EEJeffMan/LED_Lamp/CONTROLLER_PCB/ESP32 Pinout.xlsx

ESP32 pinout
Num | Desc |  |  |  |  | WROOM-32 Datasheet Recommendation | LORA gateway | WROVER kit | - | Controller PCB
1 | GND |  |  |  |  | GND | GND | GND | - | GND
2 | 3V3 |  |  |  |  | 3V3 | 3V3 | 3V3 | - | 3V3
3 | EN |  |  |  |  | R/C | Auto-reset circuit | RC & auto program circuit | - | RST
4 | SENSOR_VP |  |  |  | A1.0 | SENSOR_VP | NC |  | - | NC
5 | SENSOR_VN |  |  |  | A1.3 | SENSOR_VN | NC |  | - | NC
6 | IO34 |  |  |  | A1.6 | IO | NC | Camera D6 | - | ADC
7 | IO35 |  |  |  | A1.7 | IO | NC | Camera D7 | - | ADC
8 | IO32/32kHz | 32kHz |  |  | A1.4 | IO | RFM_DIO2 | 32kHz | - | 32kHz
9 | IO33/32kHz | 32kHz |  |  | A1.5 | IO | RFM_DIO1 | 32kHz | - | 32kHz
10 | IO25 |  |  |  | A2.8 | IO | IO | LCD SDO (MISO1) | - | BOOST_EN
11 | IO26 |  |  |  | A2.9 | IO | RFM_INT | Camera SIO_D | - | BOOST_BYPASS
12 | IO27 |  |  |  | A2.7 | IO | IO | Camera SIO_C | - | DATA_OUT
13 | IO14 | MTMS | SD_CLK | SPI_SCK | A2.6 | 100 ohm to JTAG | SPI_SCK | JTAG MTMS w/pullup & SD_CLK | - | SPI SCK
14 | IO12 | MTDI | SD_DATA2 | SPI_MISO | A2.5 | 100 ohm to JTAG | SPI_MISO | JTAG MTDI w/pullup & SD_DATA2 | - | SPI MISO | Strapping pin
15 | GND | - | - | - | - | GND | GND | GND | - | GND
16 | IO13 | MTCK | SD_DATA3 | SPI_MOSI | A2.4 | 100 ohm to JTAG | SPI_MOSI | Switch to nRTS & JTAG MTCK w/pulldown & SD_DATA3 | - | SPI MOSI & nRTS option
17 | IO9 | SHD | SD_DATA2 | SPIHD | U1RXD | NC | NC | JTAG SD2 | - | NC | Internal SPI flash
18 | IO10 | SWP | SD_DATA3 | SPIWP | U1TXD | NC | NC | JTAG SD3 | - | NC | Internal SPI flash
19 | IO11 | SCS | SD_CMD | SPICS0 | U1RTS | NC | NC | JTAG CMD | - | NC | Internal SPI flash
20 | IO6 | SCK | SD_CLK | SPICLK | U1CTS | NC | NC | JTAG CLK | - | NC | Internal SPI flash
21 | IO7 | SDO | SD_DATA0 | SPIQ | U2RTS | NC | NC | JTAG SD0 | - | NC | Internal SPI flash
22 | IO8 | SDI | SD_DATA1 | SPID | U2CTS | NC | NC | JTAG SD1 | - | NC | Internal SPI flash
23 | IO15 | MTDO | SD_CMD |  | A2.3 | 100 ohm to JTAG | NC | Switch to nCTS & JTAG MTDO w/pullup & SD_CMD | - | nCTS option | Strapping pin
24 | IO2 |  | SX_DATA0 |  | A2.2 | IO | NC | Pulldown & auto program circuit | - | TP & Pulldown & auto program circuit | Strapping pin
25 | IO0 | CLK_OUT1 |  |  | A2.1 | Jumper to GND for boot option | Button & auto-reset circuit | Pullup & auto program circuit | - | TP & Pullup & auto program circuit | Strapping pin
26 | IO4 |  | SD_DATA1 |  | A2.0 | IO | IO | Camera D0 & SD_DATA1 & RGB | - | LED_GREEN
27 | IO16 |  |  |  | U2RXD | IO | RFM_CS | IO | - | Extra UART header
28 | IO17 |  |  |  | U2TXD | IO | IO & LED | IO | - | Extra UART header
29 | IO5 |  |  |  |  | IO | IO | Camera D1 & LCD LED control | - | TP | Strapping pin
30 | IO18 |  |  |  |  | IO | IO | Camera D2 & LCD RST | - | LED_YELLOW
31 | IO19 |  |  |  | U0CTS | IO | IO | Camera D3 & LCD CLK | - | LED_RED
32 | NC | - | - | - | - | NC | NC | Tied to pin 37 | - | TP
33 | IO21 |  |  | I2C_SDA |  | IO | I2C_SDA | Camera XCLK & LCD D/C & SD DET (CD) | - | I2C SDA
34 | RXDO |  |  |  | U0RXD | UART download | RXI CH340C | FT232 via jumper | - | 0 ohm to UART TX | Place 0 ohm in series
35 | TXDO |  |  |  | U0TXD | UART download | TXO CH340C | FT232 via jumper | - | 0 ohm to UART RX | Place 0 ohm in series
36 | IO22 |  |  | I2C_SCL | U0RTS | IO | I2C_SCL | Camera PCLK & LCD CS | - | I2C SCL
37 | IO23 |  |  |  |  | IO | IO | Camera HREF & LCD MOSI (SDA) | - | TP
38 | GND | - | - | - | - | GND | GND | GND | - | GND
