EEJeffMan/LED_Lamp/POWER_PCB/Power PCB FB Node.png

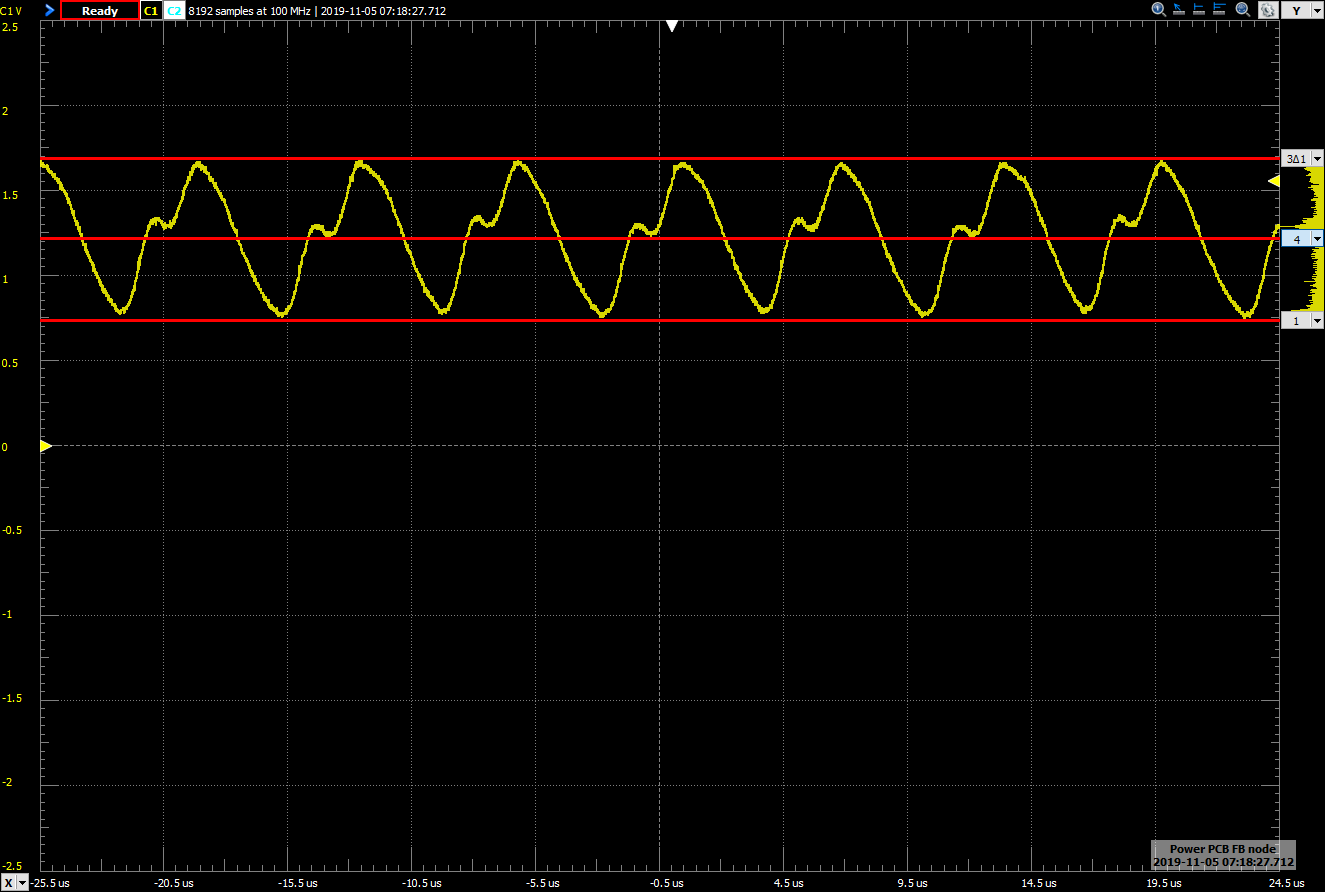
POWER_PCB/Power PCB FB Node.png
