EEJeffMan/LED_Lamp/POWER_PCB/Power PCB SW Node.png

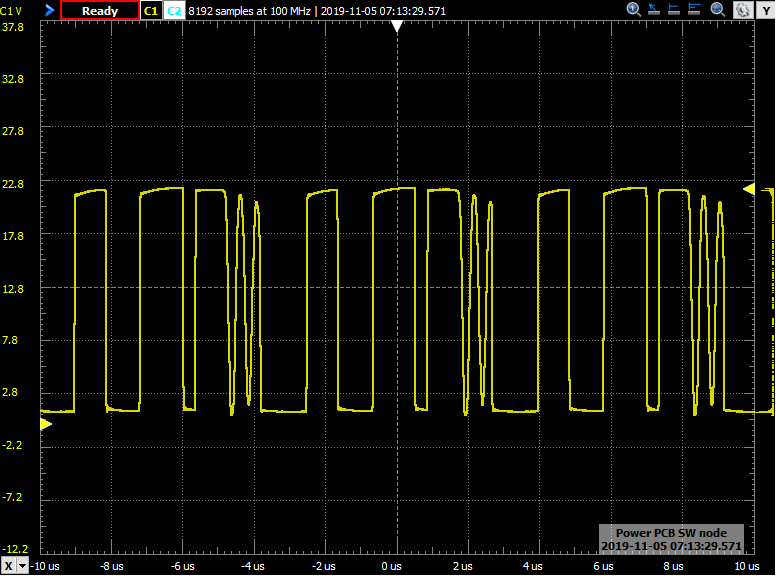
POWER_PCB/Power PCB SW Node.png
