EEJeffMan/LED_Lamp/POWER_PCB/Power PCB VOUT Node.png

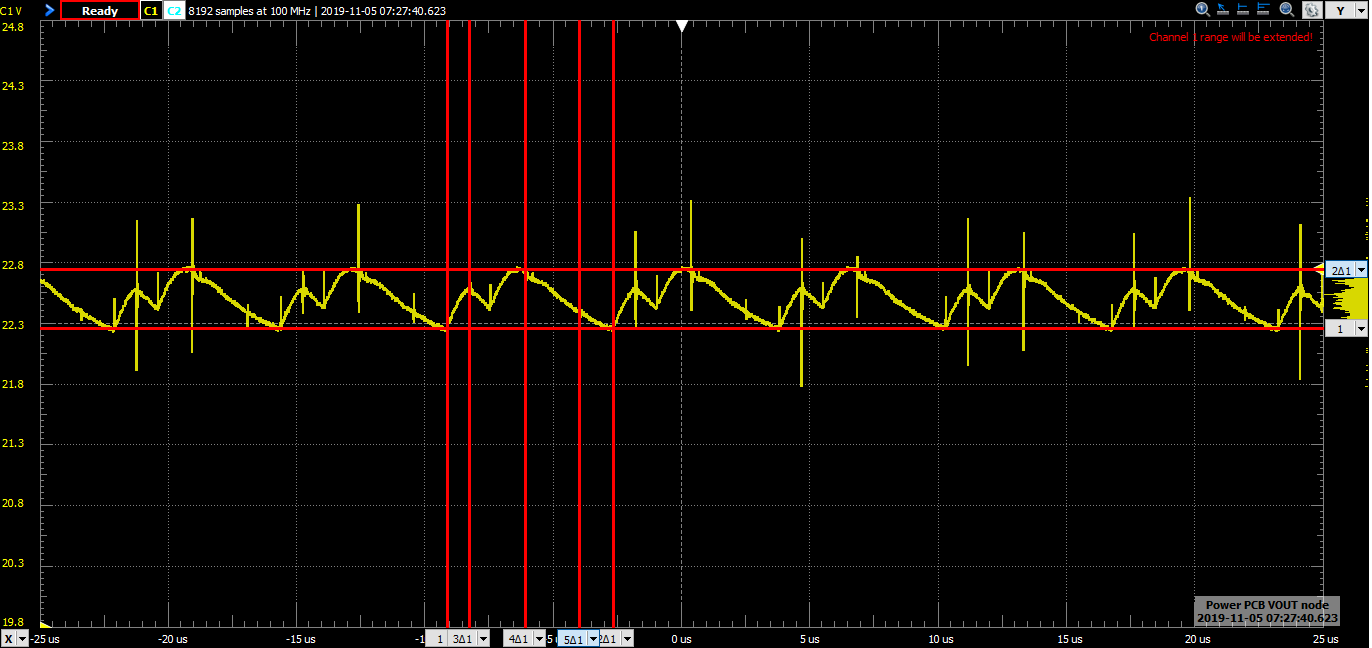
POWER_PCB/Power PCB VOUT Node.png
