EEJeffMan/LED_Lamp/LED_PCB/LED_PCB.pdf

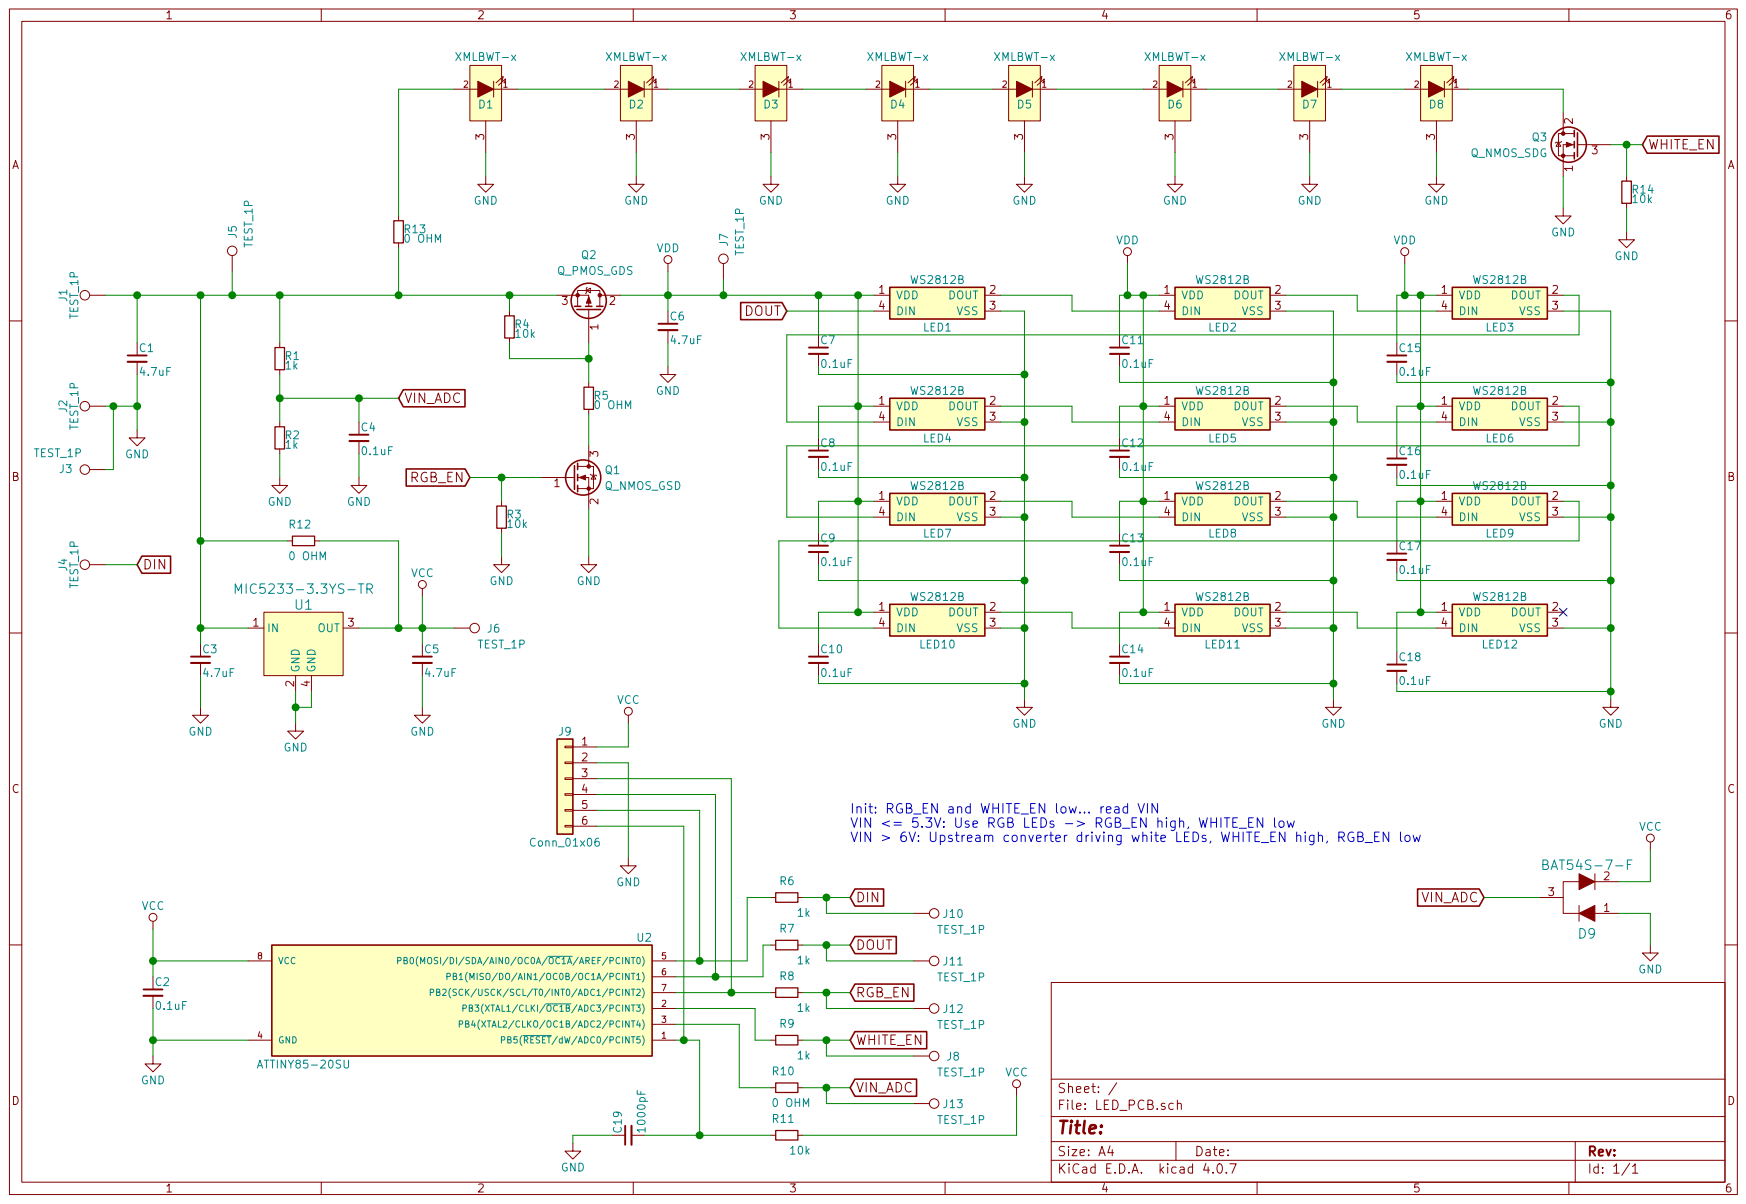
[picture p11: page 1]
