EEJeffMan/LED_Lamp/CONTROLLER_PCB/CONTROLLER_PCB.kicad_pcb

## KiCad design CONTROLLER_PCB/CONTROLLER_PCB.kicad_pcb (2019-03-01)

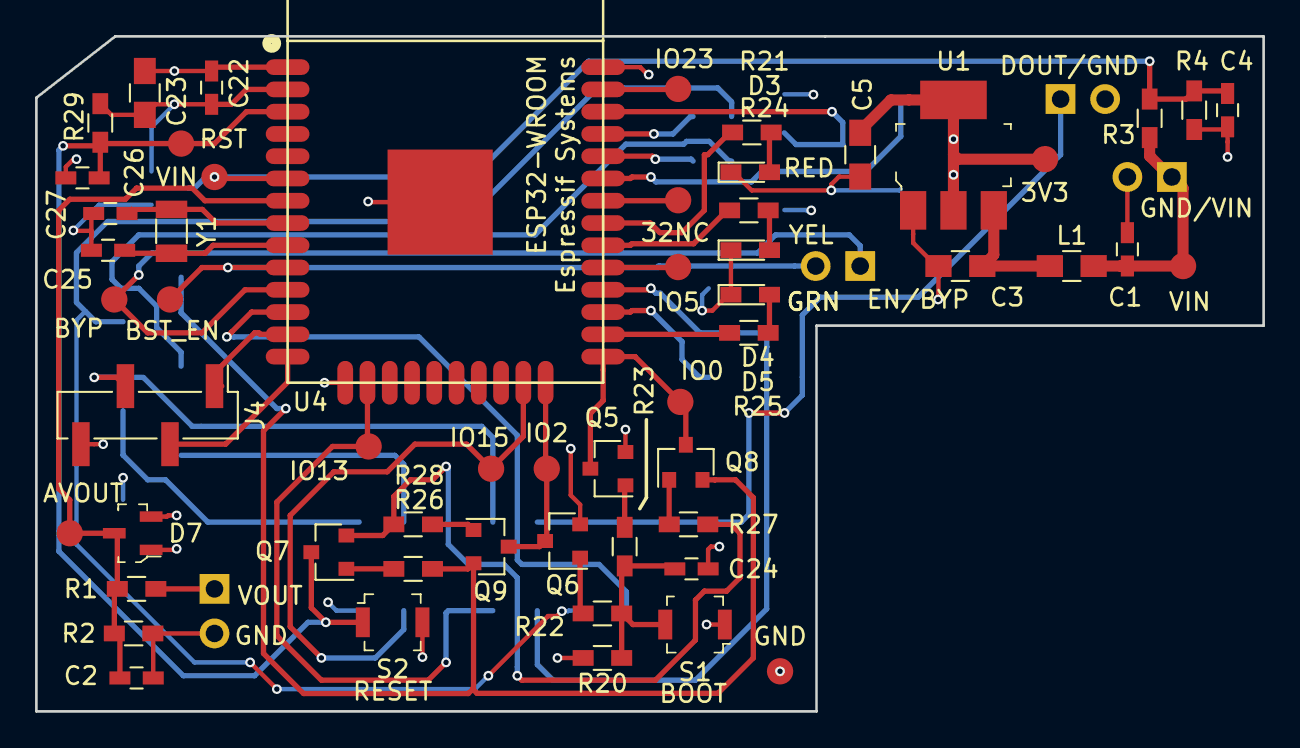
[picture p12: board CONTROLLER_PCB.kicad_pcb from above]

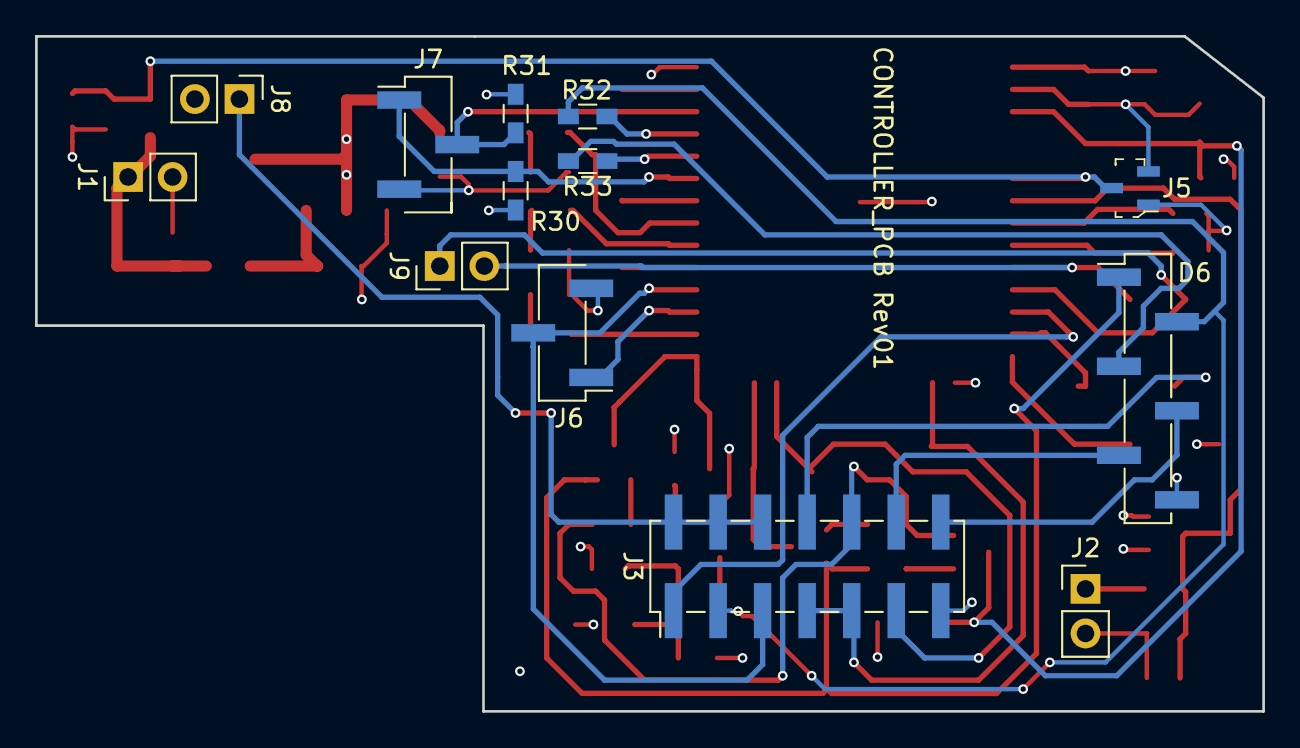
[picture p13: board CONTROLLER_PCB.kicad_pcb from below]

Board: 4 copper layers, 70.0 x 38.5 mm, 69 parts (13 on the bottom side), 48 nets.

Parts:
3V3, 32NC: TEST; Measurement_Point_Round-SMD-Pad_Small
AVOUT: TEST; Measurement_Point_Round-SMD-Pad_Small
BST_EN: TEST; Measurement_Point_Round-SMD-Pad_Small
BYP: TEST; Measurement_Point_Round-SMD-Pad_Small
C1, C2, C4, C22, C24, C27: 0.1uF; C_0603_HandSoldering
C3, C5, C23: 10uF; C_0805_HandSoldering
C25, C26: C_Small; C_0603_HandSoldering
D3: Red; LED_0603_HandSoldering
D4: Yellow; LED_0603_HandSoldering
D5: Green; LED_0603_HandSoldering
D6, D7: BAT54S-7-F; SOT-23-3
GND: TEST; Measurement_Point_Round-SMD-Pad_Small
IO0, IO2, IO5, IO13, IO15, IO23: TEST; Measurement_Point_Round-SMD-Pad_Small
J1, J2, J8, J9: Conn_01x02; Pin_Header_Straight_1x02_Pitch2.54mm
J3: Conn_02x07_Odd_Even; Pin_Header_Straight_2x07_Pitch2.54mm_SMD
J4: Conn_01x04; Pin_Header_Straight_1x04_Pitch2.54mm_SMD_Pin1Left
J5: Conn_01x06; Pin_Header_Straight_1x06_Pitch2.54mm_SMD_Pin1Left
J6, J7: Conn_01x03; Pin_Header_Straight_1x03_Pitch2.54mm_SMD_Pin1Left
L1: Ferrite_Bead; C_0805_HandSoldering
Q5, Q6: Q_NMOS_GSD; SOT-23
Q7, Q8, Q9: Q_NPN_BEC; SOT-23
R1, R3, R21, R22, R23, R24, R25, R26, R27, R28, R29: 10k; R_0603_HandSoldering
R2: 1k; R_0603_HandSoldering
R4: 2.49k; R_0603_HandSoldering
R20: 100k; R_0603_HandSoldering
R30, R31: 2.2k; R_0603_HandSoldering
R32, R33: 0 OHM; R_0603_HandSoldering
RST: TEST; Measurement_Point_Round-SMD-Pad_Small
S1, S2: B3U-1000P; Switch_Tactile_SMD_B3U-1000P
U1: AZ1117CH-3_3TRG1; SOT-223
U4: ESP32-WROOM
VIN: TEST; Measurement_Point_Round-SMD-Pad_Small
VIN#2: TEST; Measurement_Point_Round-SMD-Pad_Small
Y1: 32.768 kHz; Crystal_SMD_3215-2pin_3.2x1.5mm

Connections:
3V3_UART: J3.14, J5.4
32KHZ_IN: C26.1, U4.8, Y1.2
32KHZ_OUT: C25.1, U4.9, Y1.1
+3V3: 3V3.1, C5.1, C22.1, C23.1, D6.2, D7.2, J3.13, R29.1, R30.1, R31.1, S1.1, U1.2, U1.4, U4.2
ADC_VIN: C4.1, D6.3, R3.2, R4.1, RST.1, U4.6
ADC_VOUT: AVOUT.1, C2.1, D7.3, R1.2, R2.1, U4.7
BOOST_BYPASS: BYP.1, J9.1, U4.11
BOOST_EN: BST_EN.1, J9.2, U4.10
DOUT: J3.2, J3.4, J3.6, J8.1
DO_0: J3.1, U4.12
GND: C1.2, C2.2, C3.2, C4.2, C5.2, C22.2, C23.2, C24.2, C25.2, C26.2, C27.2, D3.1, D4.1, D5.1, D6.1, D7.1, GND.1, J1.2, J2.2, J4.4, J5.6, J6.3, J7.3, J8.2, Q5.2, Q6.2, R2.2, R4.2, R20.2, S2.2, U1.1, U4.1, U4.15, U4.38, U4.39
I2C_SCL: J7.2, R31.2, U4.36
I2C_SDA: J7.1, R30.2, U4.33
IO0: IO0.1, Q5.3, Q8.3, U4.25
IO2: IO2.1, Q6.3, Q9.3, U4.24
IO13: IO13.1, J3.7, J3.9, U4.16
IO15: IO15.1, J3.11, U4.23
LED_GREEN: R25.1, U4.26
LED_RED: R21.1, U4.31
LED_YELLOW: R24.1, U4.30
unnamed: C3.1, L1.1, U1.3
unnamed: C24.1, R20.1, R22.1, R23.1, S1.2
unnamed: D3.2, R21.2
unnamed: D4.2, R24.2
unnamed: D5.2, R25.2
unnamed: J2.1, R1.1
unnamed: Q5.1, R23.2
unnamed: Q6.1, R22.2
unnamed: Q7.1, R26.2
unnamed: Q8.1, R27.2
unnamed: Q9.1, R28.2
unnamed: R32.1, U4.35
unnamed: R33.1, U4.34
unnamed: IO23.1, U4.37
unnamed: 32NC.1, U4.32
unnamed: IO5.1, U4.29
RXDI: J5.3, R33.2
SPI_MISO: J4.2, U4.14
SPI_MOSI: J3.8, J4.3
SPI_SCK: J4.1, U4.13
TXDO: J3.3, J5.2, R32.2
U2RXD: J6.1, U4.27
U2TXD: J3.5, J6.2, U4.28
Vin: C1.1, J1.1, L1.2, R3.1, VIN.1
~CTS: J3.12, J5.5
~DTR: J5.1, Q8.2, Q9.2, R26.1
~RST: C27.1, Q7.3, R29.2, S2.1, U4.3, VIN#2.1
~RTS: J3.10, Q7.2, R27.1, R28.1
