EEJeffMan/LED_Lamp/POWER_PCB/POWER_PCB.kicad_pcb

## KiCad design POWER_PCB/POWER_PCB.kicad_pcb (2019-03-01)

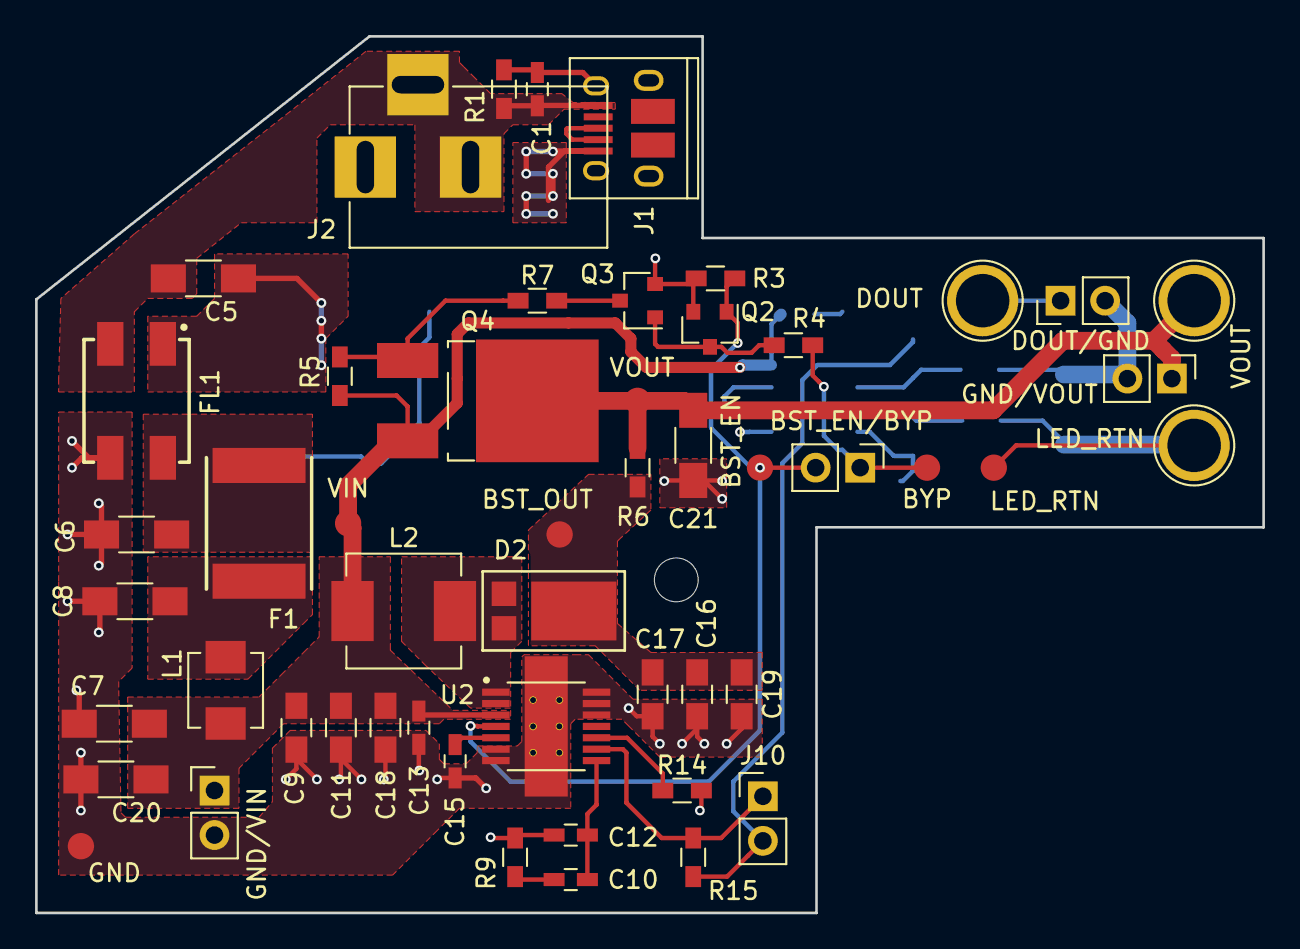
[picture p14: board POWER_PCB.kicad_pcb from above]

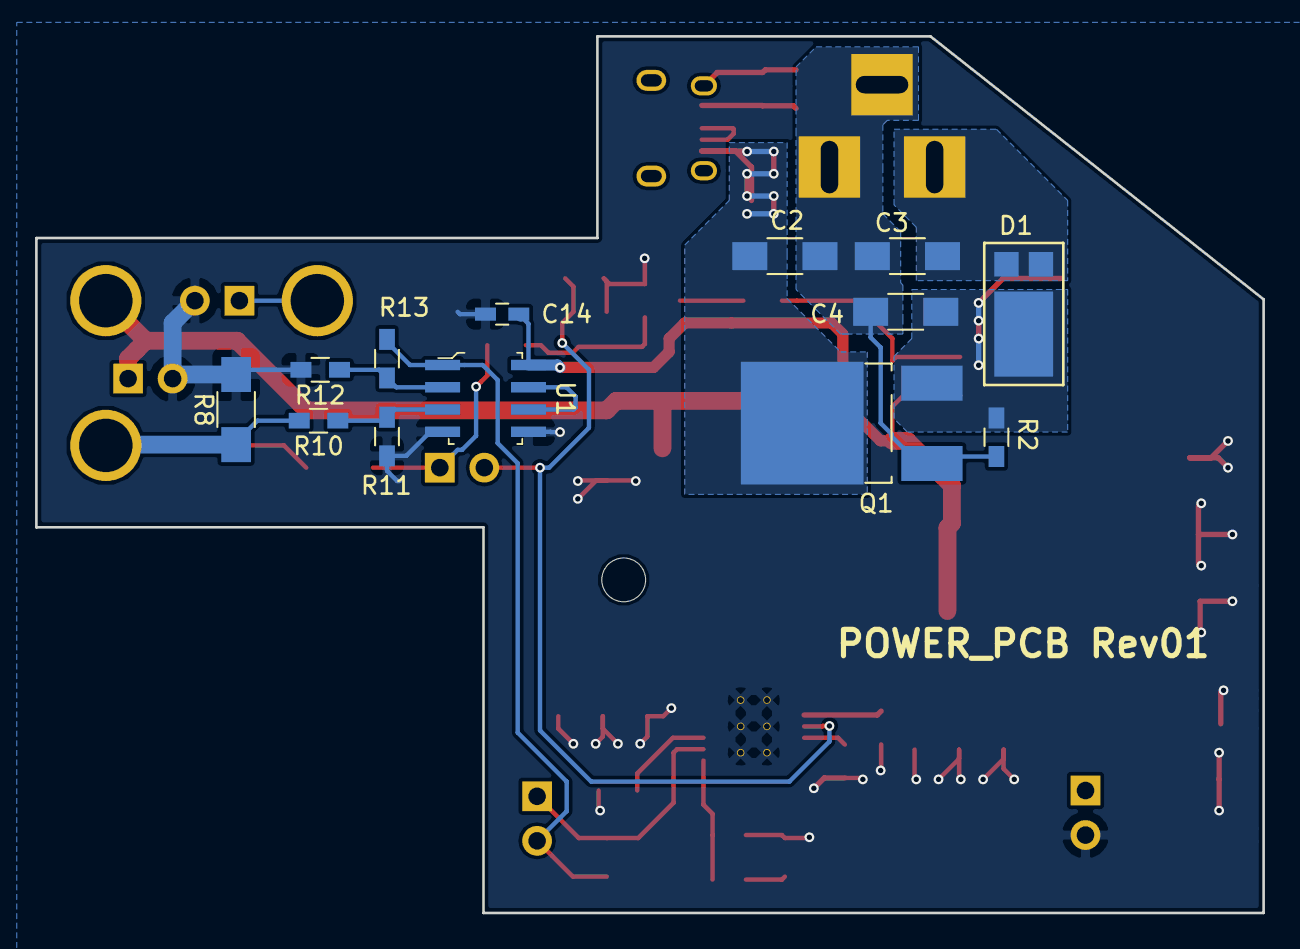
[picture p15: board POWER_PCB.kicad_pcb from below]

Board: 2 copper layers, 70.0 x 50.0 mm, 65 parts (13 on the bottom side), 29 nets.

Parts:
BST_EN: TEST; Measurement_Point_Round-SMD-Pad_Small
BST_EN/BYP: Conn_01x02; Pin_Header_Straight_1x02_Pitch2.54mm
BST_OUT: TEST; Measurement_Point_Round-SMD-Pad_Small
BYP: TEST; Measurement_Point_Round-SMD-Pad_Small
C1, C12: 100p; C_0603_HandSoldering
C2, C3, C4, C5, C6, C7, C8, C20, C21: 22uF; C_1206_HandSoldering
C9, C11, C16, C17, C18, C19: 10uF; C_0805_HandSoldering
C10, C13, C14: 0.1uF; C_0603_HandSoldering
C15: 0.01uF; C_0603_HandSoldering
D1, D2: D_Schottky_AKA; Diodes_Incorporated_POWERDI_5
DOUT: Conn_01x01; 1pin
DOUT/GND: Conn_01x02; Pin_Header_Straight_1x02_Pitch2.54mm
F1: Polyfuse; 2920L
FL1: EMI_Filter_LL_14_23; FIL_ACM70V-701-2PL-TL00
GND: TEST; Measurement_Point_Round-SMD-Pad_Small
GND/VIN: Conn_01x02; Pin_Header_Straight_1x02_Pitch2.54mm
GND/VOUT: Conn_01x02; Pin_Header_Straight_1x02_Pitch2.54mm
J1: 10103594-0001LF; USB_Micro-B_10103594-0001LF
J2: Barrel_Jack; BARREL_JACK
J10: Conn_01x02; Pin_Header_Straight_1x02_Pitch2.54mm
L1: 1uH; L_Vishay_IHLP-1616
L2: 10uH; L_Vishay_IHLP-2525
LED_RTN: Conn_01x01; 1pin
LED_RTN#2: TEST; Measurement_Point_Round-SMD-Pad_Small
Q1, Q4: Q_PMOS_GDS; TO-252-2_Rectifier
Q2, Q3: Q_NMOS_GSD; SOT-23
R1: 1M; R_0603_HandSoldering
R2: 20k; R_0603_HandSoldering
R3, R5, R11, R13: 10k; R_0603_HandSoldering
R4, R10, R12: 1k; R_0603_HandSoldering
R6, R7: 0 OHM; R_0603_HandSoldering
R8: 0.25 OHM; R_1206_HandSoldering
R9: 2.2k; R_0603_HandSoldering
R14: 30k; R_0603_HandSoldering
R15: 100 OHM; R_0603_HandSoldering
U1: TS462CDT; SOIC-8_W3.9mm
U2: TPS55340PWP; SOP65P640X120-15N_HAND_SOLDERING
VIN: TEST; Measurement_Point_Round-SMD-Pad_Small
VOUT: Conn_01x01; 1pin
VOUT#2: TEST; Measurement_Point_Round-SMD-Pad_Small

Connections:
/Input_Output/Vout: C21.1, GND/VOUT.1, Q4.2, R6.1, VOUT.1, VOUT#2.1
BOOST_BYPASS: BST_EN/BYP.1, BYP.1, R4.2
BOOST_EN: BST_EN.1, BST_EN/BYP.2, Q2.1, R3.1, U2.4
BOOST_OUT: BST_OUT.1, C16.1, C17.1, C19.1, D2.2, R6.2
DOUT: DOUT.1, DOUT/GND.1
GND: C6.2, C7.2, C8.2, C9.2, C11.2, C12.2, C13.2, C14.2, C15.2, C16.2, C17.2, C18.2, C19.2, C20.2, C21.2, DOUT/GND.2, FL1.3, GND.1, GND/VIN.2, GND/VOUT.2, Q2.2, Q3.2, R3.2, R8.2, R9.2, R11.2, R12.2, R14.2, U1.4, U1.5, U2.6, U2.7, U2.12, U2.13, U2.14, U2.15, U2.P$1, U2.P$2, U2.P$3, U2.P$4, U2.P$5, U2.P$6
LED_RTN: LED_RTN.1, LED_RTN#2.1, R8.1, R10.2
unnamed: C1.1, J1.6, R1.1
unnamed: C1.2, C2.2, C3.2, C4.2, C5.2, FL1.2, J1.5, J2.2, J2.3, Q1.1, R1.2, R2.2
unnamed: C2.1, J1.1, Q1.2
unnamed: C3.1, D1.1, D1.3, J2.1
unnamed: C4.1, C5.1, D1.2, FL1.1, Q1.3, R2.1
unnamed: C6.1, F1.2, FL1.4
unnamed: C8.1, F1.1, L1.1
unnamed: C10.1, C12.1, U2.8
unnamed: C10.2, R9.1
unnamed: C15.1, U2.5
unnamed: D2.1, D2.3, L2.2, U2.1, U2.2
unnamed: J1.2, J1.3
unnamed: J10.1, R15.1, U2.9
unnamed: J10.2, R13.1, R15.2, U1.1
unnamed: Q2.3, Q3.1, R4.1
unnamed: Q3.3, R7.2
unnamed: Q4.1, R5.2, R7.1
unnamed: R10.1, R11.1, U1.3
unnamed: R12.1, R13.2, U1.2
unnamed: R14.1, U2.10
unnamed: U1.6, U1.7
Vin: C7.1, C9.1, C11.1, C13.1, C14.1, C18.1, C20.1, GND/VIN.1, L1.2, L2.1, Q4.3, R5.1, U1.8, U2.3, VIN.1
