EEJeffMan/LED_Lamp/LED_PCB/LED_PCB.kicad_pcb

## KiCad design LED_PCB/LED_PCB.kicad_pcb (2019-02-09)

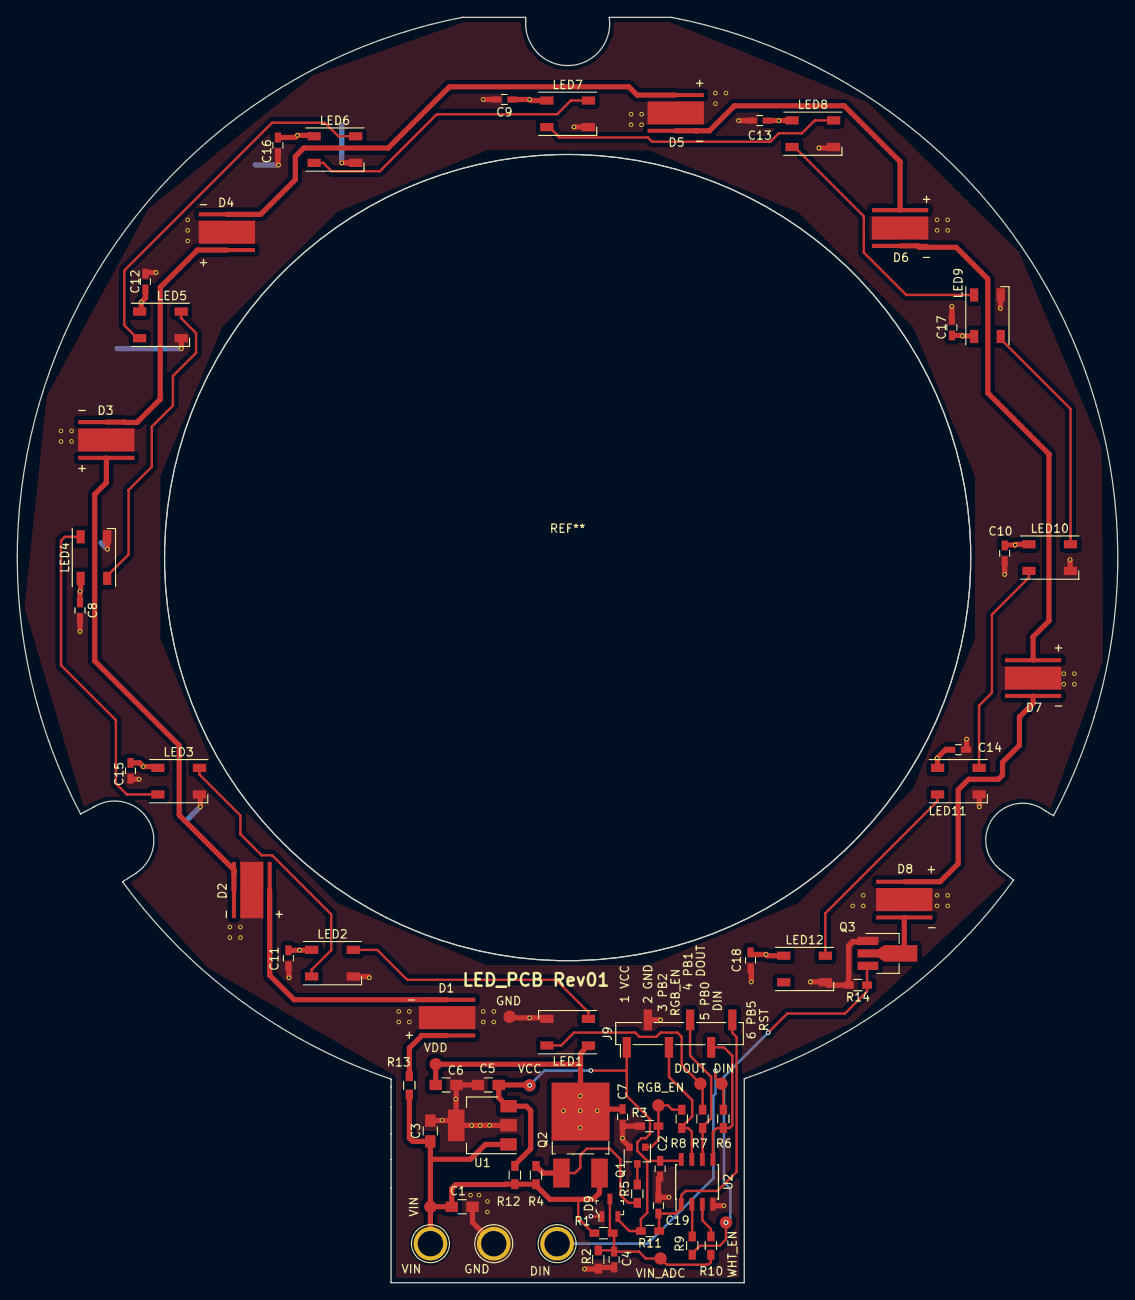
[picture p16: board LED_PCB.kicad_pcb from above]

Board: 2 copper layers, 132.4 x 152.3 mm, 72 parts (0 on the bottom side), 37 nets.

Parts:
C1, C3, C5, C6: 4.7uF; C_0805_HandSoldering
C2, C4, C7, C8, C9, C10, C11, C12, C13, C14, C15, C16, C17, C18: 0.1uF; C_0603_HandSoldering
C19: 1000pF; C_0603_HandSoldering
D1, D2, D3, D4, D5, D6, D7, D8: XMLBWT-x; CREE-XM-L_HAND_SOLDERED
D9: BAT54S-7-F; SOT-23-3
DIN: TEST_1P; 1pin
DIN#2: TEST_1P; Measurement_Point_Round-SMD-Pad_Small
DOUT: TEST_1P; Measurement_Point_Round-SMD-Pad_Small
GND: TEST_1P; 1pin
GND#2: TEST_1P; Measurement_Point_Round-SMD-Pad_Small
J9: Conn_01x06; Pin_Header_Straight_1x06_Pitch2.54mm_SMD_Pin1Left
LED1, LED2, LED3, LED4, LED5, LED6, LED7, LED8, LED9, LED10, LED11, LED12: WS2812B; LED_WS2812B-PLCC4
Q1: Q_NMOS_GSD; SOT-23
Q2: Q_PMOS_GDS; TO-252-2_Rectifier
Q3: Q_NMOS_SDG; SOT-89-3_Handsoldering
R1, R2, R6, R7, R8, R9: 1k; R_0603_HandSoldering
R3, R4, R11, R14: 10k; R_0603_HandSoldering
R5, R10, R12, R13: 0 OHM; R_0603_HandSoldering
RGB_EN: TEST_1P; Measurement_Point_Round-SMD-Pad_Small
U1: MIC5233-3.3YS-TR; SOT-223
U2: ATTINY85-20SU; SOIC-8_3.9x4.9mm_Pitch1.27mm
VCC: TEST_1P; Measurement_Point_Round-SMD-Pad_Small
VDD: TEST_1P; Measurement_Point_Round-SMD-Pad_Small
VIN: TEST_1P; 1pin
VIN#2: TEST_1P; Measurement_Point_Round-SMD-Pad_Small
VIN_ADC: TEST_1P; Measurement_Point_Round-SMD-Pad_Small
WHT_EN: TEST_1P; Measurement_Point_Round-SMD-Pad_Small

Connections:
DIN: DIN.1, DIN#2.1, R6.2
DOUT: DOUT.1, LED1.4, R7.2
GND: C1.2, C2.2, C3.2, C4.2, C5.2, C6.2, C7.2, C8.2, C9.2, C10.2, C11.2, C12.2, C13.2, C14.2, C15.2, C16.2, C17.2, C18.2, C19.1, D1.3, D2.3, D3.3, D4.3, D5.3, D6.3, D7.3, D8.3, D9.1, GND.1, GND#2.1, J9.2, LED1.3, LED2.3, LED3.3, LED4.3, LED5.3, LED6.3, LED7.3, LED8.3, LED9.3, LED10.3, LED11.3, LED12.3, Q1.2, Q3.1, R2.2, R3.2, R14.2, U1.2, U1.4, U2.4
unnamed: C1.1, C3.1, Q2.3, R1.1, R4.1, R12.1, R13.2, U1.1, VIN.1, VIN#2.1
unnamed: C19.2, J9.6, R11.1, U2.1
unnamed: D1.1, D2.2
unnamed: D1.2, R13.1
unnamed: D2.1, D3.2
unnamed: D3.1, D4.2
unnamed: D4.1, D5.2
unnamed: D5.1, D6.2
unnamed: D6.1, D7.2
unnamed: D7.1, D8.2
unnamed: D8.1, Q3.2
unnamed: J9.3, R8.1, U2.7
unnamed: J9.4, R7.1, U2.6
unnamed: J9.5, R6.1, U2.5
unnamed: LED1.2, LED2.4
unnamed: LED2.2, LED3.4
unnamed: LED3.2, LED4.4
unnamed: LED4.2, LED5.4
unnamed: LED5.2, LED6.4
unnamed: LED6.2, LED7.4
unnamed: LED7.2, LED8.4
unnamed: LED8.2, LED9.4
unnamed: LED10.2, LED11.4
unnamed: LED9.2, LED10.4
unnamed: LED11.2, LED12.4
unnamed: Q1.3, R5.2
unnamed: Q2.1, R4.2, R5.1
unnamed: R9.1, U2.2
unnamed: R10.1, U2.3
RGB_EN: Q1.1, R3.1, R8.2, RGB_EN.1
VCC: C2.1, C5.1, D9.2, J9.1, R11.2, R12.2, U1.3, U2.8, VCC.1
VDD: C6.1, C7.1, C8.1, C9.1, C10.1, C11.1, C12.1, C13.1, C14.1, C15.1, C16.1, C17.1, C18.1, LED1.1, LED2.1, LED3.1, LED4.1, LED5.1, LED6.1, LED7.1, LED8.1, LED9.1, LED10.1, LED11.1, LED12.1, Q2.2, VDD.1
VIN_ADC: C4.1, D9.3, R1.2, R2.1, R10.2, VIN_ADC.1
WHITE_EN: Q3.3, R9.2, R14.1, WHT_EN.1
