EEJeffMan/LED_Lamp/(commit log)

2019-01-26 Added LED_LAMP.xml
2019-01-31 Creating LED_PCB project
    [LED_PCB.kicad_pcb, LED_PCB.sch]
2019-01-31 Added symbols & wired schematic, need to assign values / PNs / footprints
2019-02-01 Finished schematic & BOM, started layout, need to define PCB shape
    [LED_PCB.csv, LED_PCB.sch]
2019-02-03 Added housing outline and started board outline.
    [LED_PCB.kicad_pcb]
2019-02-03 Finished board outline, and started placing LEDs
    [LED_PCB.kicad_pcb]
2019-02-04 LED board: routed most of top layer... started controller PCB schematic.
    [CONTROLLER_PCB.kicad_pcb, CONTROLLER_PCB.sch, ESP32.sch, INPUT_POWER.sch, LED_PCB.csv, LED_PCB.kicad_pcb, LED_PCB.sch]
2019-02-06 LED PCB: Changed to 2 layer, added vias and copper (not complete). Controller: Split up ESP32 and input & power sheets in schematic.
    [INPUT_POWER.sch, LED_PCB.kicad_pcb]
2019-02-08 Added components to LED PCB sch and updated layout
    Still need to add thermals for white LEDs and then run error check...
    [LED_PCB.csv, LED_PCB.kicad_pcb, LED_PCB.sch]
2019-02-08 Finished layout and created gerbers.
    [LED_PCB.kicad_pcb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]
2019-02-09 Updated layout to add giant mounting hole for center opening; ordered PCB's with this design.
    [LED_PCB.csv, LED_PCB.kicad_pcb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]
2019-02-09 Created ESP32 pinout spreadsheet, finished MCU pinout, and added MCU_SUPPORT schematic sheet.
    [CONTROLLER_PCB.sch, ESP32 Pinout.xlsx, ESP32.sch, INPUT_POWER.sch, MCU_SUPPORT.sch]
2019-02-10 Added input filtering, and assigned footprints to most components, several remain.
    [ESP32.sch, INPUT_POWER.sch, MCU_SUPPORT.sch]
2019-02-11 Finalized schematic, created BOM, started placement (no PCB size yet)
    [CONTROLLER_PCB.csv, CONTROLLER_PCB.kicad_pcb, CONTROLLER_PCB.sch, ESP32 Pinout.xlsx, ESP32.sch, INPUT_POWER.sch, MCU_SUPPORT.sch]
2019-02-11 Updated placement...
    [CONTROLLER_PCB.kicad_pcb]
2019-02-23 Updated BOM & added PCB shape to layout... this is right before removing power supply components...
    [CONTROLLER_PCB.kicad_pcb, LED_PCB.csv]
2019-02-23 Split up power supply and MCU into 2 different boards, schematic design not complete.
    [INPUT_POWER.sch, Input_Output.sch, LED_Boost.sch, POWER_PCB.kicad_pcb, POWER_PCB.sch]
2019-02-26 Updated POWER_PCB & CONTROLLER_PCB sch's and layouts
    [CONTROLLER_PCB.csv, CONTROLLER_PCB.kicad_pcb, ESP32.sch, INPUT_POWER.sch, Input_Output.sch, LED_Boost.sch, MCU_SUPPORT.sch, POWER_PCB - Copy.csv]
2019-02-27 Finished controller layout, and 80% done with power PCB layout.
    [CONTROLLER_PCB.csv, CONTROLLER_PCB.kicad_pcb, POWER_PCB - Copy.csv, POWER_PCB.csv, POWER_PCB.kicad_pcb]
2019-03-01 Finished copper, silkscreen and gerbers for power PCB and controller PCBs,
    [CONTROLLER_PCB.kicad_pcb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]
2019-03-09 Created source code for LED board MCU.
2019-03-09 Many updates for LED_PCB MCU firmware.
2019-03-10 Updates to LED_PCB MCU firmware.
2019-03-11 Added FastLED library to repo, modified some code for improved bring-up verification, and added comments regarding setting up ATTINY in arduino IDE.
2019-11-08 Added waveforms of boost with 100k freq resistor, white LEDs at 0.3 ohm sense and 10k/1k gain
